botblox/RouterCore-Nano-DaughterBoard-Designs/RouterCoreNanoBaseRevA/BOM-BB-RNB-A-1.xlsx

No | Ref | Value | Description | Manufacturer | Manufacturer Part Number | LCSC | Footprint | Quantity | Supplier 1 | Cost @10pcs | Cost @1000pcs
1 | C1, C5, C6, C13, C14, C18, | 0.1uF | CAP CER 0.1UF 50V X7R 0402 | Murata Electronics | GCM155R71H104KE02D | C85858 | Kpk:C_0402_Small | 6 | LCSC | 0.0085 | 0.0067
2 | C2, C3, C8, C9, C10, C11, C16, C17, | 47uF | CAP CER 47UF 10V X5R 0805 | TDK | C2012X5R1A476MTJ00E | C76636 | Capacitor_SMD:C_0805_2012Metric | 8 | LCSC | 0.1986 | 0.122
3 | C4, C7, C12, C15, | 1uF | CAP CER 1UF 10V X6S 0402 | Murata Electronics | GRM155C81A105KA12D | C162161 | Kpk:C_0402_Small | 4 | LCSC | 0.0285 | 0.0204
4 | C19, C20, C21, | 22uF | CAP CER 22UF 10V X7R 0805 | Murata Electronics | GRM21BZ71A226ME15L | C907991 | Capacitor_SMD:C_0805_2012Metric | 3 | LCSC | 0.2551 | 0.1752
5 | C22, C23, | 2.2u | CAP CER 2.2UF 100V X7R 1206 | Samsung Electro-Mechanics | CL31B225KCHSNNE | C170101 | Kpk:C_1206_Small | 2 | LCSC | 0.1339 | 0.0826
6 | C24, | 0.1uF/100V | CAP CER 0.1UF 100V X7R 0603 | YAGEO | CC0603KRX7R0BB104 | C113803 | Kpk:C_0603_Small | 1 | LCSC | 0.0116 | 0.0088
7 | D1, | Zener12V | DIODE ZENER 12V 300MW SOD323 | ON Semiconductor | MM3Z12VT1G | C236177 | Diode_SMD:D_SOD-323 | 1 | LCSC | 0.0474 | 0.0337
8 | D2, | SMAJ54CA | TVS DIODE 54V 87.1V DO214AC | Littelfuse | SMAJ54CA | C2649855 | Diode_SMD:D_SMA | 1 | LCSC | 0.1152 | 0.1104
9 | D3, D4, D5, | GREEN | LED GREEN CLEAR CHIP SMD | Everlight Elec | 16-213SYGC/S530-E3/TR8 | C264408 | LED_SMD:LED_0402_1005Metric | 3 | LCSC | 0.0211 | 0.0135
10 | H1, H2, H3, H4, | SMTWE2050MTJ | ROUND STANDOFF M2X0.4 STEEL 5MM | Sinhoo | SMTWE2050MTJ | C2928183 | Kpk:MountingHole_M2_9774050243R_SMTWE2050MTJ | 4 | LCSC | 0.1076 | 0.1017
11 | J1, | LSHM-150-02.5-L-DV-A-N-K-TR | CONN SELF-MATE 100POS SMD GOLD | Samtec Inc. | LSHM-150-02.5-L-DV-A-N-K-TR | C2940507 | Connector_Samtec:Samtec_LSHM-150-xx.x-x-DV-N_2x50_P0.50mm_Vertical | 1 | Digikey | 6.371 | 4.64002
12 | J2, J3, J4, J5, J6, J7, J8, J9, J10, J11, J12, | 2147210080 | ZERO-HACHI 8P 0.8 HDR SR RA ETP | Molex | 2147210080 | C5492017 | Kpk:Molex_Zero-Hachi_214721-00XX_1x08_P0.8mm_Horizontal | 11 | Digikey | 1.311 | 0.94681
13 | J13, J14, | SFP+ | CONN SFP+ RCPT 20POS SLD R/A SMD | Molex | 744410001 | C277615 | Kpk:Connector_SFP | 2 | LCSC | 0.6597 | 0.43
14 | L1, L2, L3, L4, | 3.3uH | FIXED IND 3.3UH 1.8A 135MOHM SMD | Murata Electronics | DFE252012F-3R3M=P2 | C2041573 | Inductor_SMD:L_1008_2520Metric | 4 | LCSC | 0.197 | 0.1445
15 | L5, | 2.2uH | FIXED IND 2.2UH 7A 29 MOHM SMD | Shenzhen Sunlord Electronics Co., Ltd. | MWSA0503S-2R2MT | C408408 | Inductor_SMD:L_Sunlord_MWSA0503S | 1 | LCSC | 0.1542 | 0.1012
16 | N1, | SFP+_CAGE | CONN SFP+ CAGE 1X2 PRESS-FIT R/A | CND-tek | SFP 20072631 1X2Y+ | C42931391 | Kpk:AMPHENOL_U77A261M2071 | 1 | LCSC | 1.2274 | 0.8531
17 | Q1, | FDMC86139P | MOSFET P-CH 100V 4.4A/15A 8MLP | onsemi | FDMC86139P | C463243 | Kpk:VSON-8_3.3x3.3mm_P0.65mm_FDMC86139P | 1 | LCSC | 0.9686 | 0.6162
18 | R1, | DNP | DNP |  | DNP |  | Resistor_SMD:R_0603_1608Metric | 1
19 | R2, | 56K | RES SMD 56K OHM 1% 1/16W 0402 | YAGEO | RC0402FR-0756KL | C114756 | Resistor_SMD:R_0402_1005Metric | 1 | LCSC | 0.0026 | 0.002
20 | R3, R4, R10, R15, R24, | DNP | DNP |  | DNP |  | Resistor_SMD:R_0402_1005Metric | 5
21 | R5, R17, R27, | 1K | RES SMD 1K OHM 1% 1/16W 0402 | YAGEO | RC0402FR-071KL | C106235 | Resistor_SMD:R_0402_1005Metric | 3 | LCSC | 0.0038 | 0.0029
22 | R6, R7, R8, R9, R11, R12, R16, R18, R19, R20, R21, R22, R25, | 4.99K | RES 4.99K OHM 1% 1/16W 0402 | YAGEO | RC0402FR-074K99L | C137965 | Resistor_SMD:R_0402_1005Metric | 13 | LCSC | 0.0017 | 0.0014
23 | R13, R14, R23, | 100R | RES 100 OHM 1% 1/16W 0402 | YAGEO | RC0402FR-07100RL | C106232 | Resistor_SMD:R_0402_1005Metric | 3 | LCSC | 0.0022 | 0.0018
24 | R26, R29, | 10K | RES SMD 10K OHM 1% 1/16W 0402 | YAGEO | RC0402FR-0710KL | C60490 | Resistor_SMD:R_0402_1005Metric | 2 | LCSC | 0.0023 | 0.0019
25 | R28, | 31.6K | RES 31.6K OHM 1% 1/16W 0402 | YAGEO | RC0402FR-0731K6L | C276265 | Resistor_SMD:R_0402_1005Metric | 1 | LCSC | 0.0012 | 0.001
26 | TP1, TP2, TP3, TP4, TP5, TP6, TP7, TP8, | TP | TestPoint |  | DNP |  | TestPoint:TestPoint_Pad_D1.0mm | 8
27 | U1, | TCA9543APWR | IC BUS SWITCH 2 X 1:2 14-TSSOP | Texas Instruments | TCA9543APWR | C2653307 | Package_SO:TSSOP-14_4.4x5mm_P0.65mm | 1 | LCSC | 0.7306 | 0.5254
28 | U2, | LMR51635YDDCR | SIMPLE SWITCHER SYNCHRONOUS BUCK | Texas Instruments | LMR51635YDDCR | C45262770 | Package_TO_SOT_SMD:SOT-23-6 | 1 | LCSC | 1.5997 | 1.1365
 |  |  |  |  |  |  |  |  |  | 31.0832 | 22.15323
