botblox/RouterCore-Nano-DaughterBoard-Designs/RouterCoreBaseRevA Manufacture Data/BB-RPB-A-1 Manufacture Data/BOM-BB-RPB-A-1.xlsx

No | Ref | Value | Description | Manufacturer | Manufacturer Part Number | LCSC | Footprint | Quantity | Supplier 1 | Cost @10pcs | Cost @1000pcs
1 | C1, C2, C7, C8, C10, C11, C16, C17, C18, C19, C24, C25, | 47uF | CAP CER 47UF 10V X5R 0805 | TDK | C2012X5R1A476MTJ00E | C76636 | Capacitor_SMD:C_0805_2012Metric | 12 | LCSC | 0.1599 | 0.0817
2 | C3, C6, C12, C15, C20, C23, | 1uF | CAP CER 1UF 10V X6S 0402 | Murata Electronics | GRM155C81A105KA12D | C162161 | Kpk:C_0402_Small | 6 | LCSC | 0.0122 | 0.0098
3 | C4, C5, C9, C13, C14, C21, C22, C26, | 0.1uF | CAP CER 0.1UF 50V X7R 0402 | Murata Electronics | GCM155R71H104KE02D | C85858 | Kpk:C_0402_Small | 8 | LCSC | 0.003 | 0.0023
4 | C27, C28, C32, | 22uF | CAP CER 22UF 10V X7R 0805 | Murata Electronics | GRM21BZ71A226ME15L | C907991 | Capacitor_SMD:C_0805_2012Metric | 3 | LCSC | 0.121 | 0.0787
5 | C29, C30, | 2.2u | CAP CER 2.2UF 100V X7R 1206 | Samsung Electro-Mechanics | CL31B225KCHSNNE | C170101 | Kpk:C_1206_Small | 2 | LCSC | 0.0758 | 0.0507
6 | C31, | 0.1uF/100V | CAP CER 0.1UF 100V X7R 0603 | YAGEO | CC0603KRX7R0BB104 | C113803 | Kpk:C_0603_Small | 1 | LCSC | 0.0041 | 0.0031
7 | D1, | 12V | DIODE ZENER 12V 300MW SOD323 | ON Semiconductor | MM3Z12VT1G | C236177 | Diode_SMD:D_SOD-323 | 1 | LCSC | 0.0508 | 0.0354
8 | D2, | SMAJ54CA | TVS DIODE 54V 87.1V DO214AC | Littelfuse | SMAJ54CA | C2649855 | Diode_SMD:D_SMA | 1 | LCSC | 0.1721 | 0.1052
9 | D3, D4, D5, D6, | GREEN | LED GREEN CLEAR CHIP SMD | Everlight Elec | 16-213SYGC/S530-E3/TR8 | C264408 | LED_SMD:LED_0402_1005Metric | 4 | LCSC | 0.0224 | 0.0143
10 | H1, H2, H3, H4, | MountingHole | MountingHole |  | DNP |  | MountingHole:MountingHole_2.7mm_M2.5 | 4
11 | H5, H6, H7, H8, | MountingHole | MountingHole |  | DNP |  | Kpk:MountingHole_2.3mm_M2 | 4
12 | J1, | SEAF-20-05.0-L-10-2-A-K-TR | CONN HD ARRAY RCPT 200P SMD GOLD | SAMTEC | SEAF-20-05.0-L-10-2-A-K-TR | C6216347 | Kpk:SAMTEC_SEAF-20-05.0-L-10-2-A-K-TR | 1 | Digi-Key | 16.856 | 10.1
13 | J2, | 2147210101 | ZERO-HACHI 10P 0.8 HDR SR RA ETP AU | Molex | 2147210101 | C19802771 | Kpk:Molex_Zero-Hachi_214721-00XX_1x10_P0.8mm_Horizontal | 1 | Digi-Key | 2.096 | 1.55214
14 | J4, | 2147210121 | ZERO-HACHI 12P 0.8 HDR SR RA ETP AU | Molex | 2147210121 |  | Kpk:Molex_Zero-Hachi_214721-00XX_1x12_P0.8mm_Horizontal | 1 | Digi-Key | 2.082 | 1.54114
15 | J5, J6, J7, J8, J9, J10, J11, J12, J13, J14, J15, J16, J17, J18, J19, J20, | 2147210081 | ZERO-HACHI 8P 0.8 HDR SR RA ETP AU | Molex | 2147210081 |  | Kpk:Molex_Zero-Hachi_214721-00XX_1x08_P0.8mm_Horizontal | 16 | Digi-Key | 1.425 | 1.0296
16 | J21, J22, J23, | SFP+ | CONN SFP+ RCPT 20POS SLD R/A SMD | Molex | 744410001 | C277615 | Kpk:Connector_SFP | 3 | LCSC | 0.6954 | 0.4771
17 | L1, L2, L3, L4, L5, L6, | 3.3uH | FIXED IND 3.3UH 1.8A 135MOHM SMD | Murata Electronics | DFE252012F-3R3M=P2 | C2041573 | Inductor_SMD:L_1008_2520Metric | 6 | LCSC | 0.1702 | 0.107
18 | L7, | 2.2uH | FIXED IND 2.2UH 7A 29 MOHM SMD | Shenzhen Sunlord Electronics Co., Ltd. | MWSA0503S-2R2MT | C408408 | Inductor_SMD:L_Sunlord_MWSA0503S | 1 | LCSC | 0.2667 | 0.1561
19 | N1, | DNP | DNP |  | DNP |  | Kpk:Connector_SFP_and_Cage_10731013W008_CZT_SmallCageHole_Custom | 1
20 | Q1, | FDMC86139P | MOSFET P-CH 100V 4.4A/15A 8MLP | onsemi | FDMC86139P | C463243 | Kpk:VSON-8_3.3x3.3mm_P0.65mm_FDMC86139P | 1 | LCSC | 0.7194 | 0.4607
21 | R1, | DNI | DNP |  | DNP |  | Resistor_SMD:R_0603_1608Metric | 1
22 | R2, | 56K | RES SMD 56K OHM 1% 1/16W 0402 | Yageo | RC0402FR-0756KL | C114756 | Resistor_SMD:R_0402_1005Metric | 1 | LCSC | 0.0007 | 0.0005
23 | R3, R16, R25, R35, | 1K | RES SMD 1K OHM 1% 1/16W 0402 | Yageo | RC0402FR-071KL | C106235 | Resistor_SMD:R_0402_1005Metric | 4 | LCSC | 0.0006 | 0.0005
24 | R4, R5, R6, R7, R8, R13, R17, R18, R19, R20, R21, R24, R26, R27, R28, R29, R30, R33, | 4.99K | RES 4.99K OHM 1% 1/16W 0402 | Yageo | RC0402FR-074K99L | C137965 | Resistor_SMD:R_0402_1005Metric | 18 | LCSC | 0.0007 | 0.0005
25 | R9, R15, R22, R31, | 100R | RES 100 OHM 1% 1/16W 0402 | Yageo | RC0402FR-07100RL | C106232 | Resistor_SMD:R_0402_1005Metric | 4 | LCSC | 0.0007 | 0.0006
26 | R10, R11, R12, R14, R23, R32, | DNP | DNP |  | DNP |  | Resistor_SMD:R_0402_1005Metric | 6
27 | R34, R37, | 10K | RES SMD 10K OHM 1% 1/16W 0402 | Yageo | RC0402FR-0710KL | C60490 | Resistor_SMD:R_0402_1005Metric | 2 | LCSC | 0.0006 | 0.0004
28 | R36, | 31.6K | RES 31.6K OHM 1% 1/16W 0402 | Yageo | RC0402FR-0731K6L | C276265 | Resistor_SMD:R_0402_1005Metric | 1 | LCSC | 0.0007 | 0.0005
29 | TP1, TP2, TP3, TP4, TP5, TP6, TP7, TP8, TP9, TP10, | TP | TestPoint |  | DNP |  | TestPoint:TestPoint_Pad_D1.0mm | 10
30 | U1, | TCA9544A | IC MULTIPLEXER 1 X 1:4 20TSSOP | Texas Instruments | TCA9544APWR | C2674619 | Package_SO:TSSOP-20_4.4x6.5mm_P0.65mm | 1 | Texas Instruments | 0.6667 | 0.4226
31 | U2, | LMR51635YDDCR | SIMPLE SWITCHER SYNCHRONOUS BUCK | Texas Instruments | LMR51635YDDCR | C45262770 | Package_TO_SOT_SMD:SOT-23-6 | 1 | Digi-Key | 1.605 | 0.7
 |  |  |  |  |  |  |  |  |  | 53.0668 | 35.09078
