botblox/RouterCore-Nano-DaughterBoard-Designs/RouterCoreNanoBaseRevA/3D-BB-RNB-A-1.step

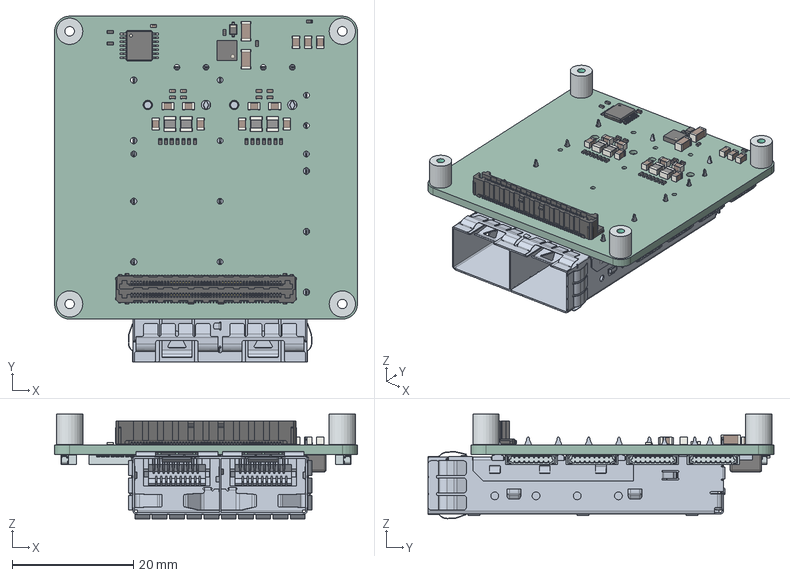
[picture p1: CAD file, 2026-10-26]
RouterCoreNanoBaseRevA/3D-BB-RNB-A-1.step
50.0 x 57.1 x 17.2 mm
C_0805_2012Metric x 11
R_0402_1005Metric x 23
VSON_8_33x33mm_Pitch065mm_NexFET
L_1008_2520Metric x 4
C_0402_1005Metric x 10
C_1206_3216Metric x 2
LSHM-150-02.5-L-DV-A-N-TR
TSSOP_14_44x5mm_P065mm
D_SOD_323
D_SMA
2147210081wbm000_01 x 11
SOT_23_6
CQ assembly
LED_0402_1005Metric x 3
M-U77-A261M-X071-REVT1
C_0603_1608Metric
RouterCoreNanoBaseRevA_PCB
