botblox/RouterCore-Nano-DaughterBoard-Designs/RouterCoreBaseRevA Manufacture Data/BB-RPB-A-1 Manufacture Data/PCB FABRICATION NOTES - BB-RPB-A-1.docx

PCB FABRICATION NOTES

BOARD NAME:

KAPEK BB-RPB-A-1

1) PCB TO BE MANUFACTURED IN ACCORDANCE WITH IPC6012, CURRENT REVISION, PERFORMANCE CLASS 2.

2) 8-LAYER RIGID PCB. MATERIAL FR4 1.6mm THICK.

3) PROCESS: APPLY GREEN SOLDERMASK OVER BARE COPPER ON L1 (TOP) AND L8 (BOTTOM).

4) APPLY ENIG TO EXPOSED PADS ON, L1 AND L8, AFTER SOLDERMASK. MINIMUM THICKNESS PER IPC6012 CLASS 2.

5) SILKSCREEN COMPONENT LOCATION MARKINGS, WHITE PERMANENT, NON-CONDUCTIVE INK, L1 AND L8, PER SUPPLIED GERBER FILE.

6) MINIMUM COPPER IN PLATED HOLES PER IPC6012, CURRENT REVISION, CLASS 2.

7) ALL TOLERANCES PER IPC6012 CLASS 2.

8) FABRICATE AND INSPECT TO IPC CLASS 2 STANDARDS. PCB IS FOR INDUSTRIAL USE. IN CASE OF CONFLICT, SUPERCEDE IPC SPECIFICATION.

9) LAYER 1 IS TOP COPPER. LAYER SEQUENCE IS TOP / IN1 / IN2 / IN3 / IN4 / IN5/ IN6 /BOT (L1 / L2 / L3 / L4 / L5 / L6 / L7 / L8).

10) 100% ELECTRICAL TEST REQUIRED FOR SHORTS AND OPENS.

11) SUPPLY AS INDIVIDUAL PCBS.

12) IF PAD IS LARGER THAN NON-PLATED HOLE, DO NOT REMOVE PAD, AND DO NOT REMOVE ANY COPPER FROM PAD.

13) USE 1-OZ ON EXTERNAL LAYERS.

14) USE 1-OZ ON INTERNAL LAYERS.

15) IMPEDANCE REQUIREMENT: 100 OHM DIFFERENTIAL PAIR AS IN ATTACHED FILES
