botblox/RouterCore-Nano-DaughterBoard-Designs/RouterCoreBaseRevA Manufacture Data/BB-RPB-A-1 Manufacture Data/3D Images/BB-RPB-A-1 BOT.png

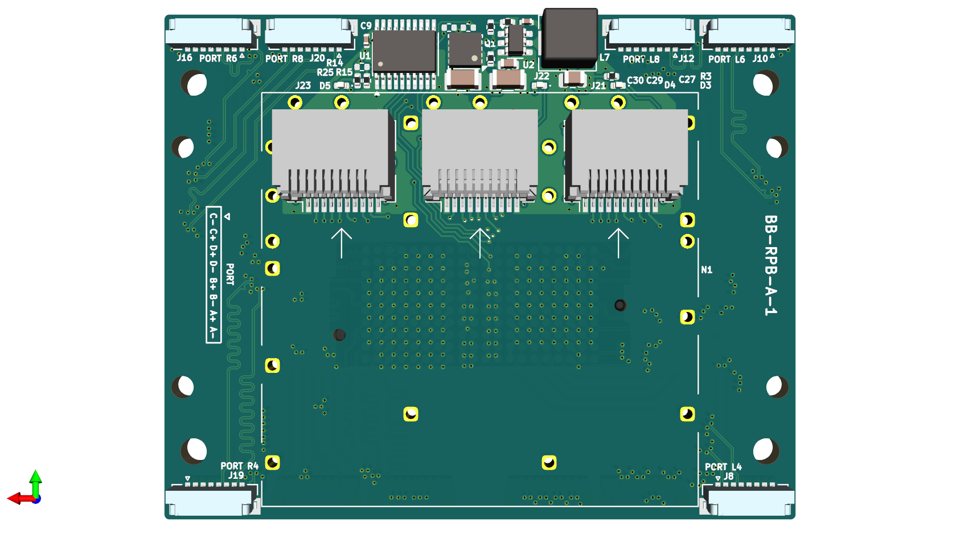
RouterCoreBaseRevA Manufacture Data/BB-RPB-A-1 Manufacture Data/3D Images/BB-RPB-A-1 BOT.png
