botblox/RouterCore-Nano-DaughterBoard-Designs/RouterCoreNanoBaseRevA/SCH-BB-RNB-A-1.pdf

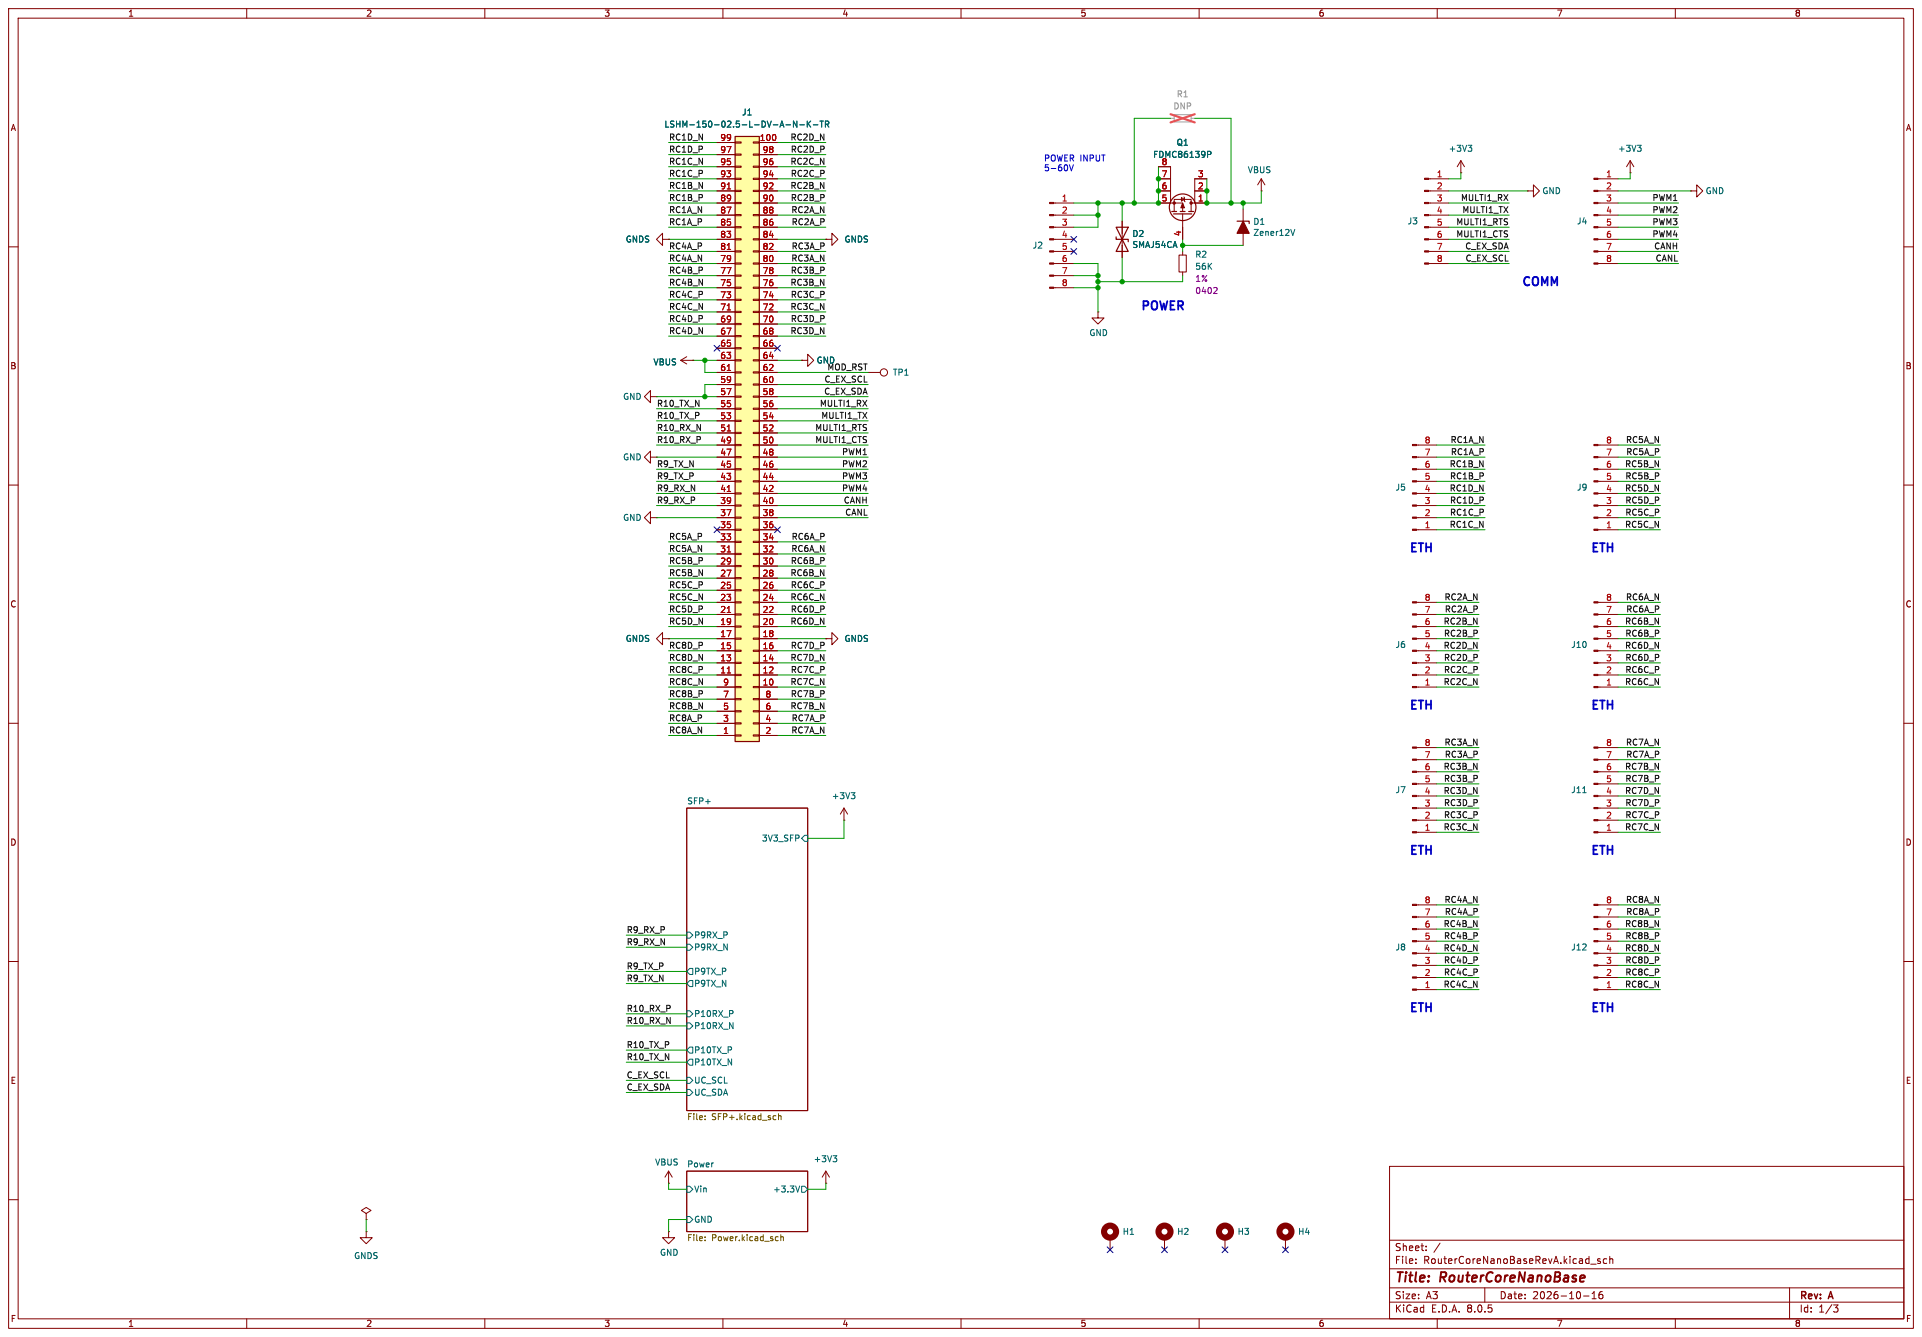
[picture p8: page 1]

Vin Power File: Power.kicad_sch

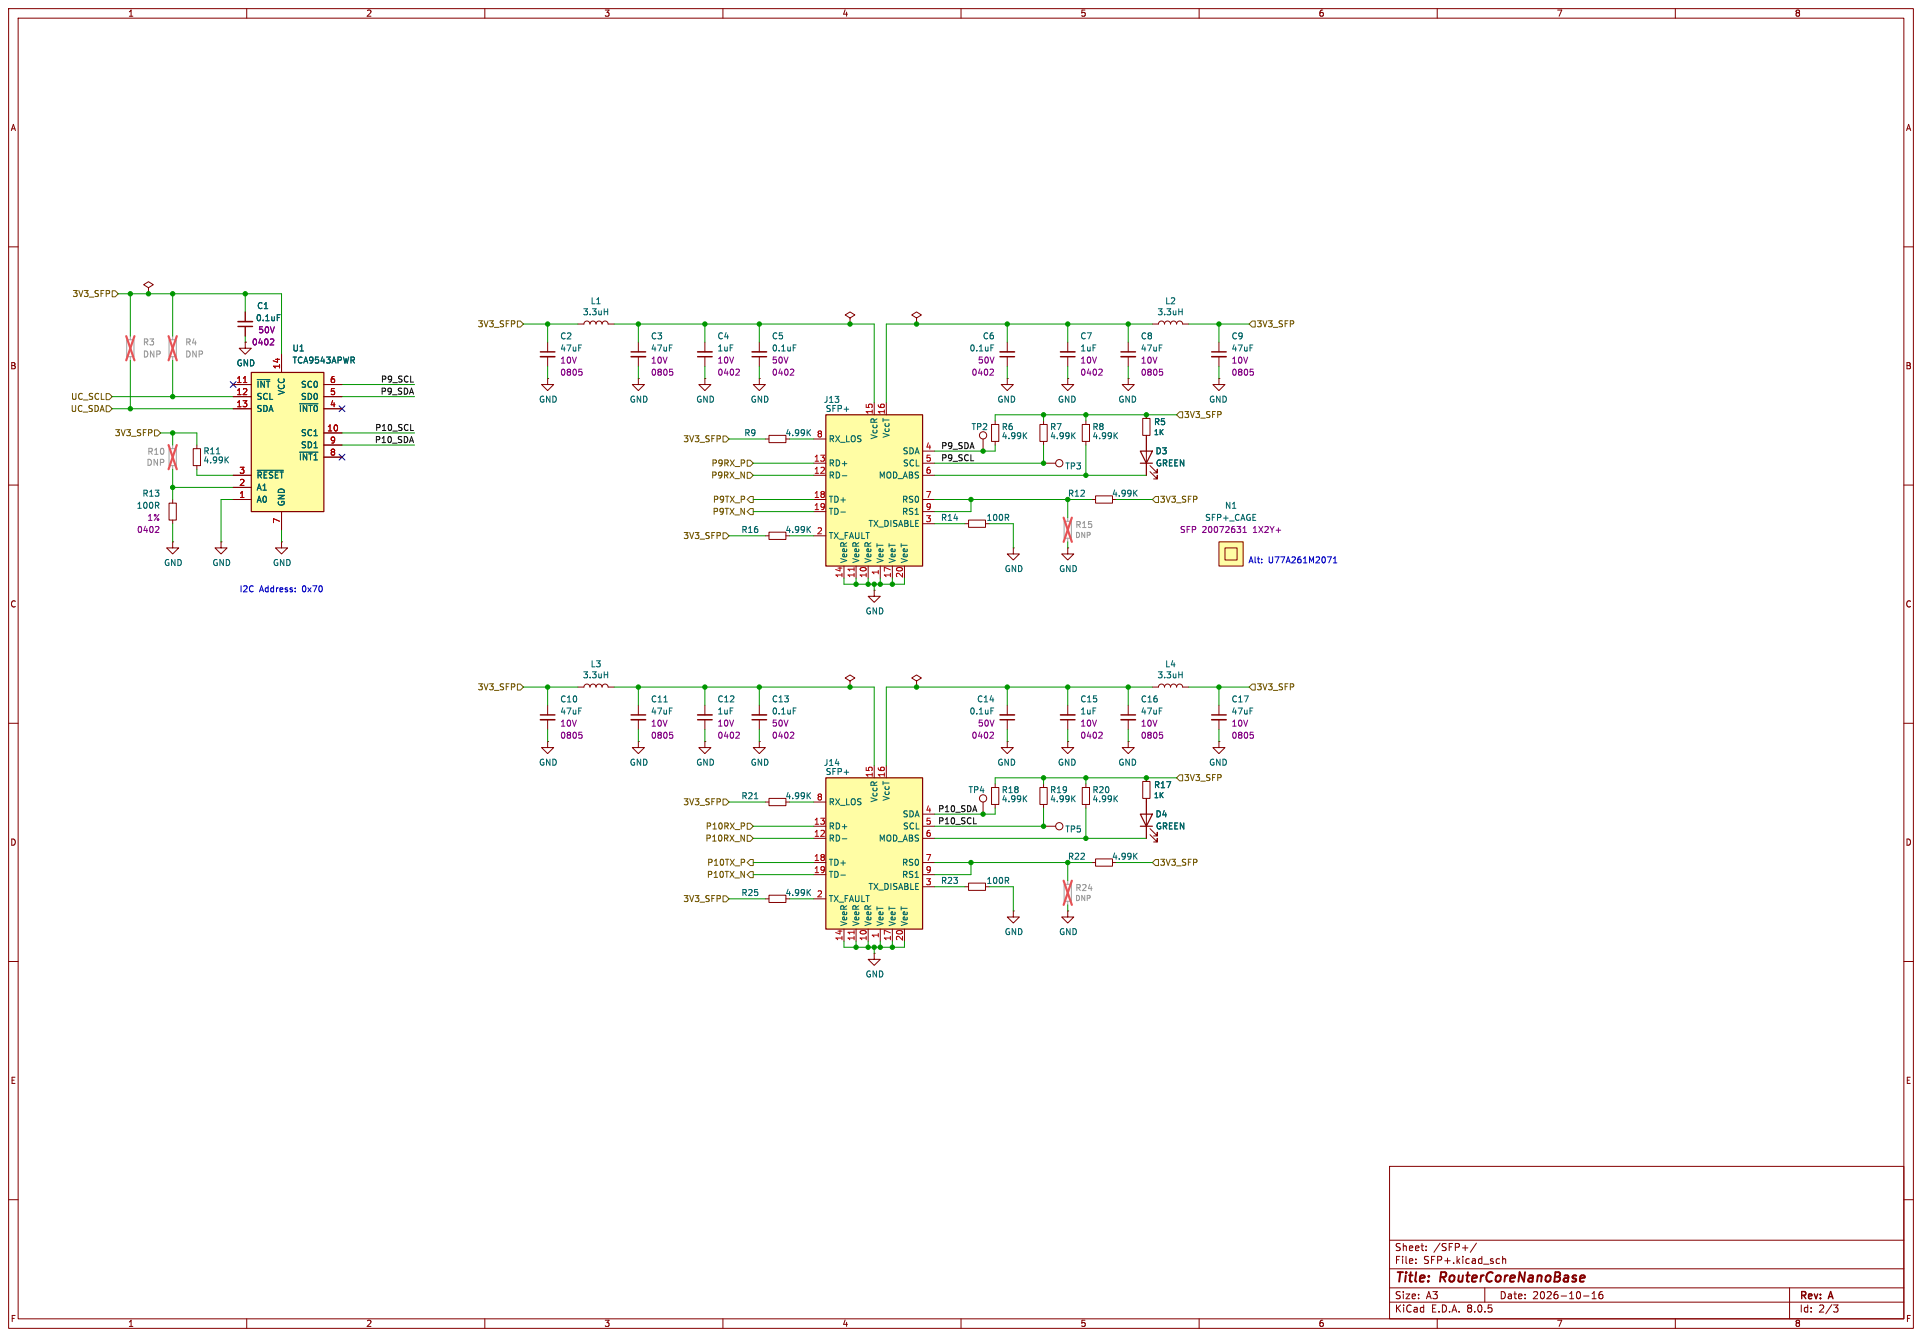
[picture p9: page 2]

1 VeeR 10 VeeR 11 RD- 12 RD+ 13 VeeR 14 VccR 15 VccT 16 VeeT 17 TD+ 18 TD- 19 TX_FAULT 2 VeeT 20 TX_DISABLE 3 SDA 4 SCL 5 MOD_ABS 6 RS0 7 RX_LOS 8 RS1 9

File: SFP+.kicad_sch Sheet: /SFP+/ VeeT

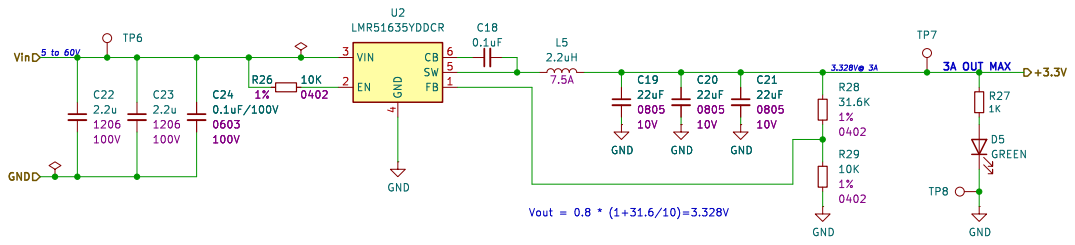
[picture p10: page 3]

File: Power.kicad_sch Sheet: /Power/
Id: 3/3 Title: RouterCoreNanoBase
