botblox/RouterCore-Nano-DaughterBoard-Designs/RouterCoreBaseRevA Manufacture Data/BB-RPB-A-1 Manufacture Data/Impedance requirement/BOT-DiffPair100Ohm_YellowHighlighted.pdf

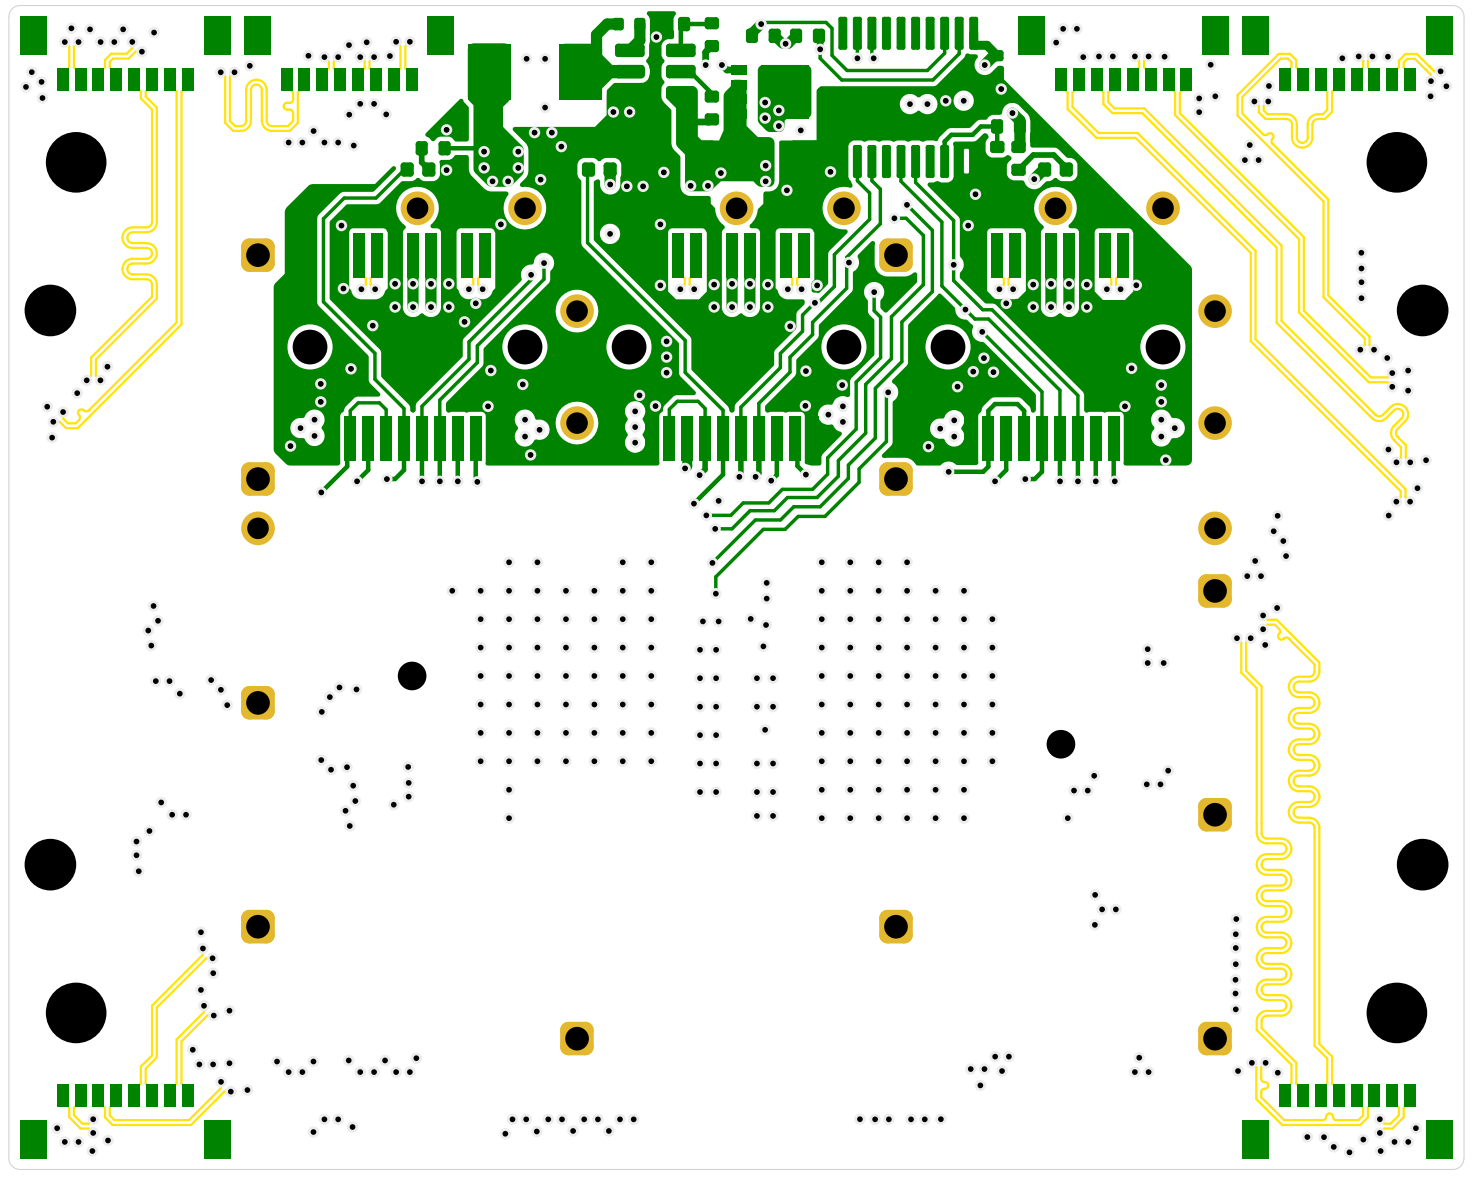
[picture p11: page 1]
