botblox/RouterCore-Nano-DaughterBoard-Designs/RouterCoreBaseRevA Manufacture Data/BB-RPB-A-1 Manufacture Data/Impedance requirement/IN2-DiffPair100Ohm_YellowHighlighted.pdf

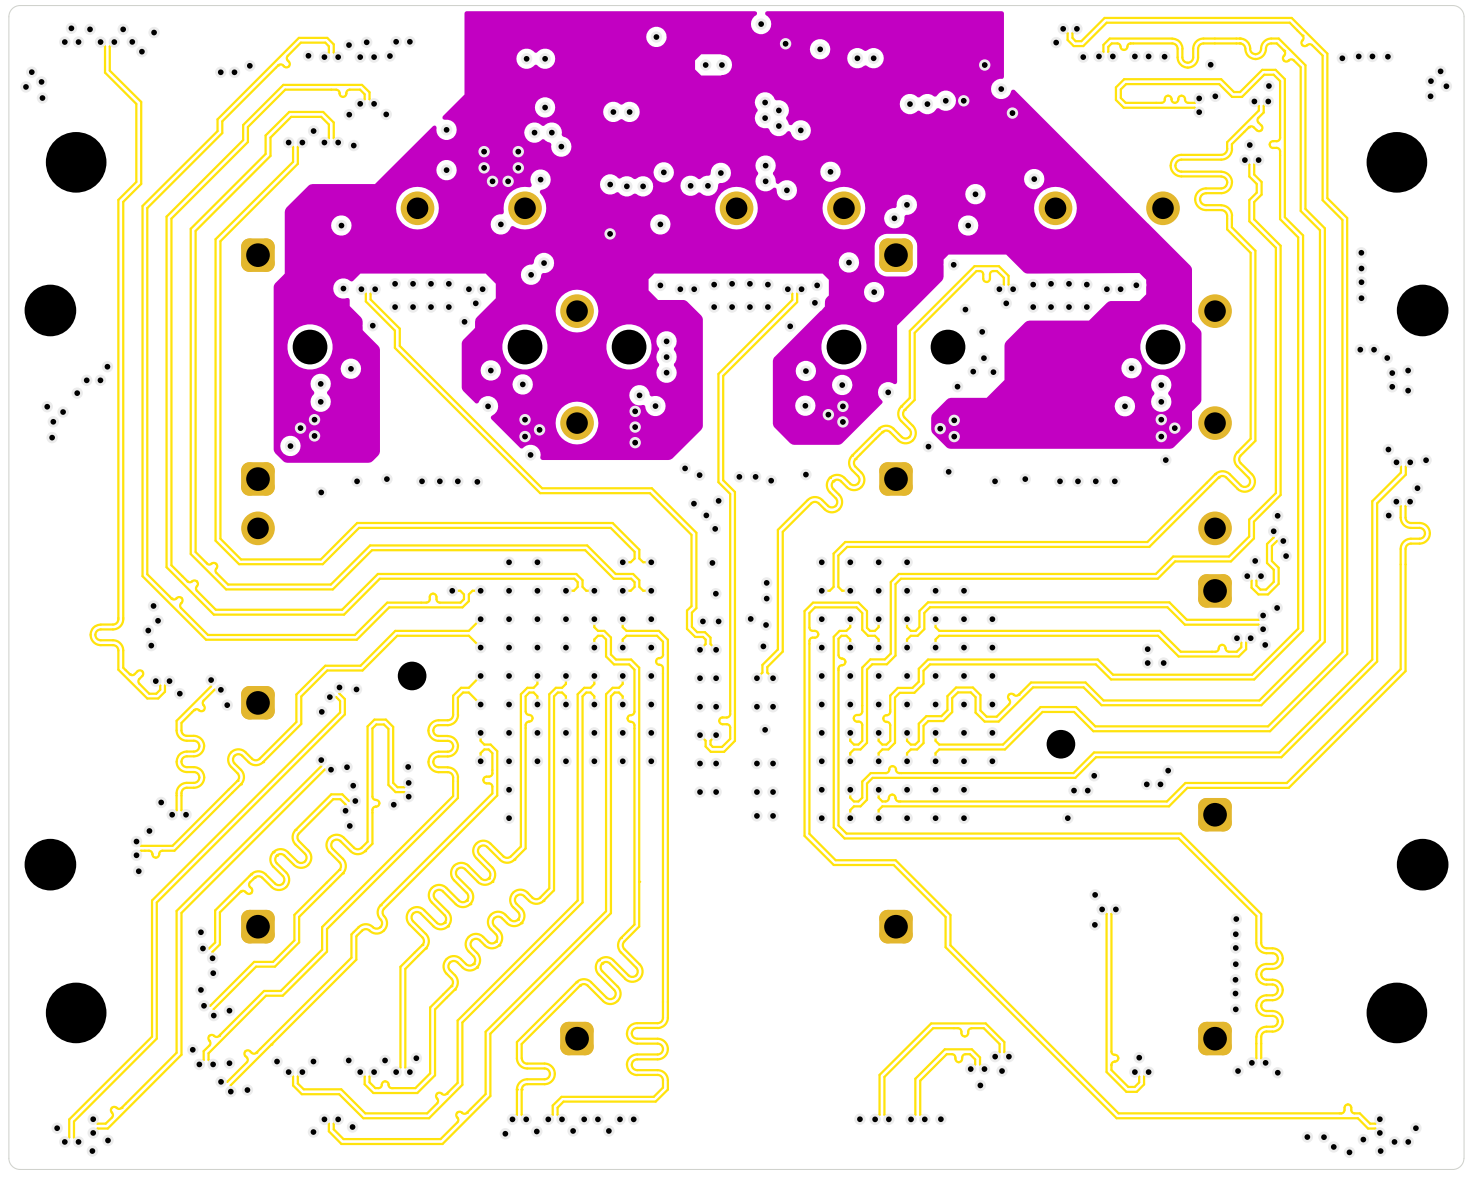
[picture p12: page 1]
