botblox/RouterCore-Nano-DaughterBoard-Designs/RouterCoreBaseRevA Manufacture Data/BB-RPB-A-1 Manufacture Data/Impedance requirement/IN4-DiffPair100Ohm_YellowHighlighted.pdf

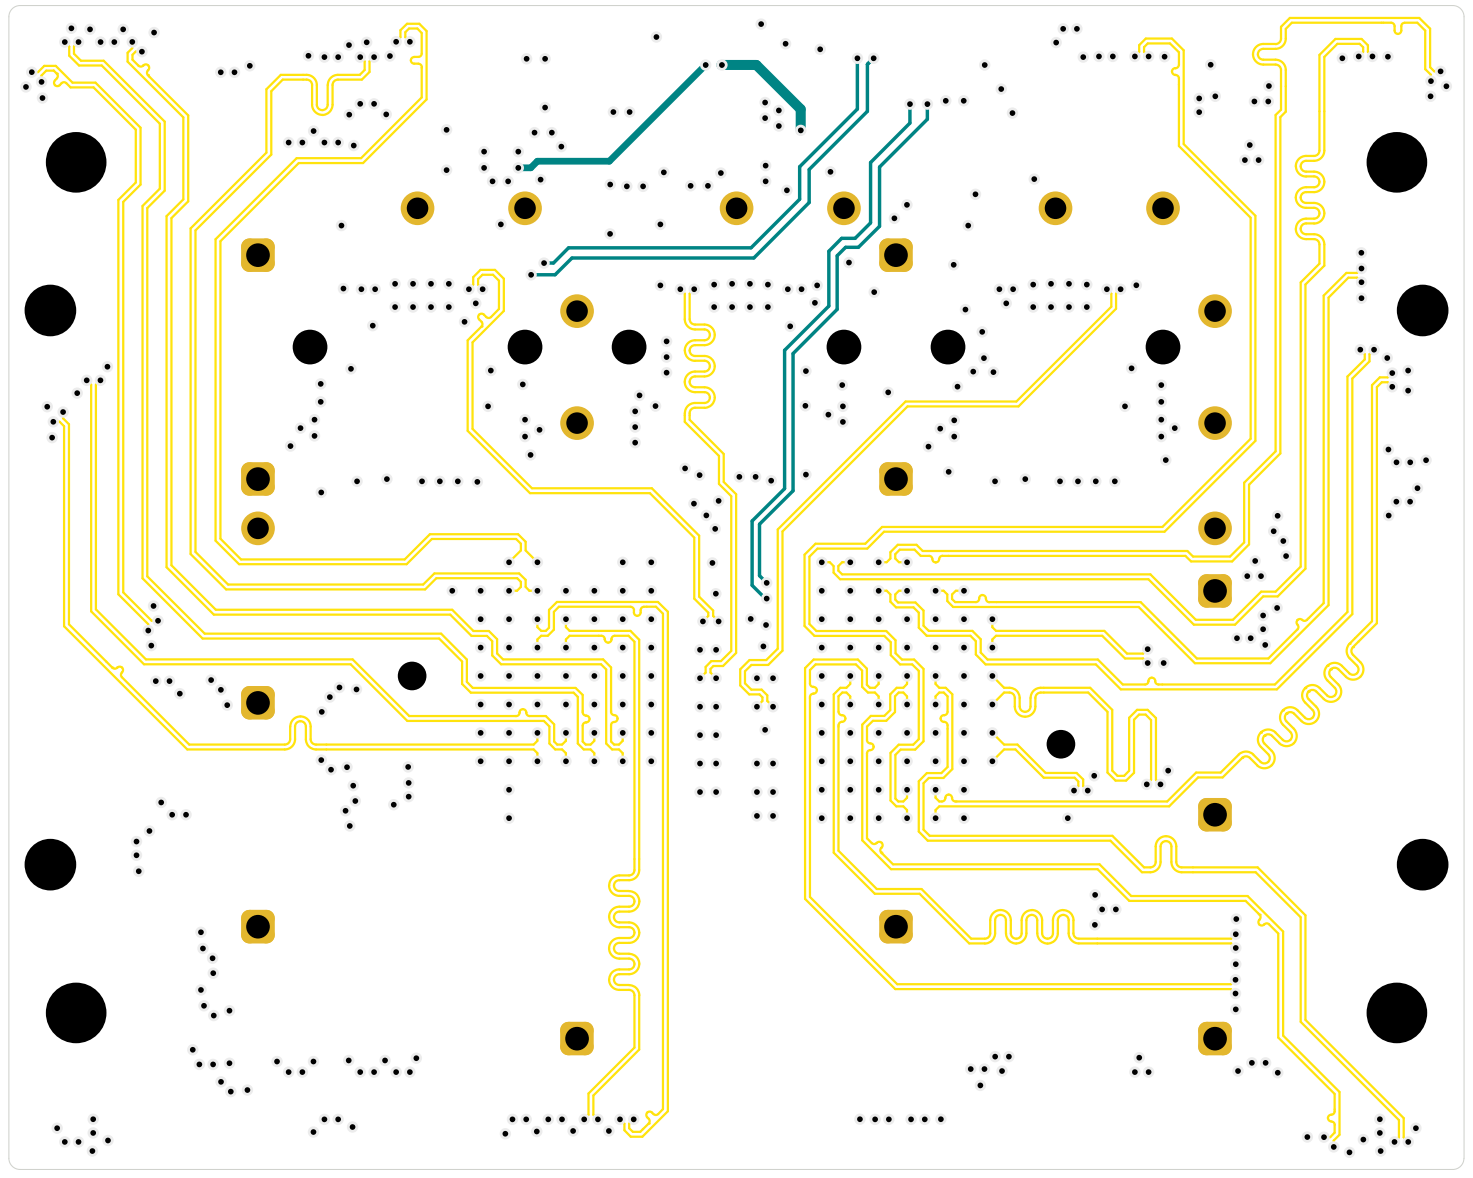
[picture p13: page 1]
