botblox/RouterCore-Nano-DaughterBoard-Designs/RouterCoreBaseRevA Manufacture Data/BB-RPB-A-1 Manufacture Data/Impedance requirement/TOP-DiffPair100Ohm_YellowHighlighted.pdf

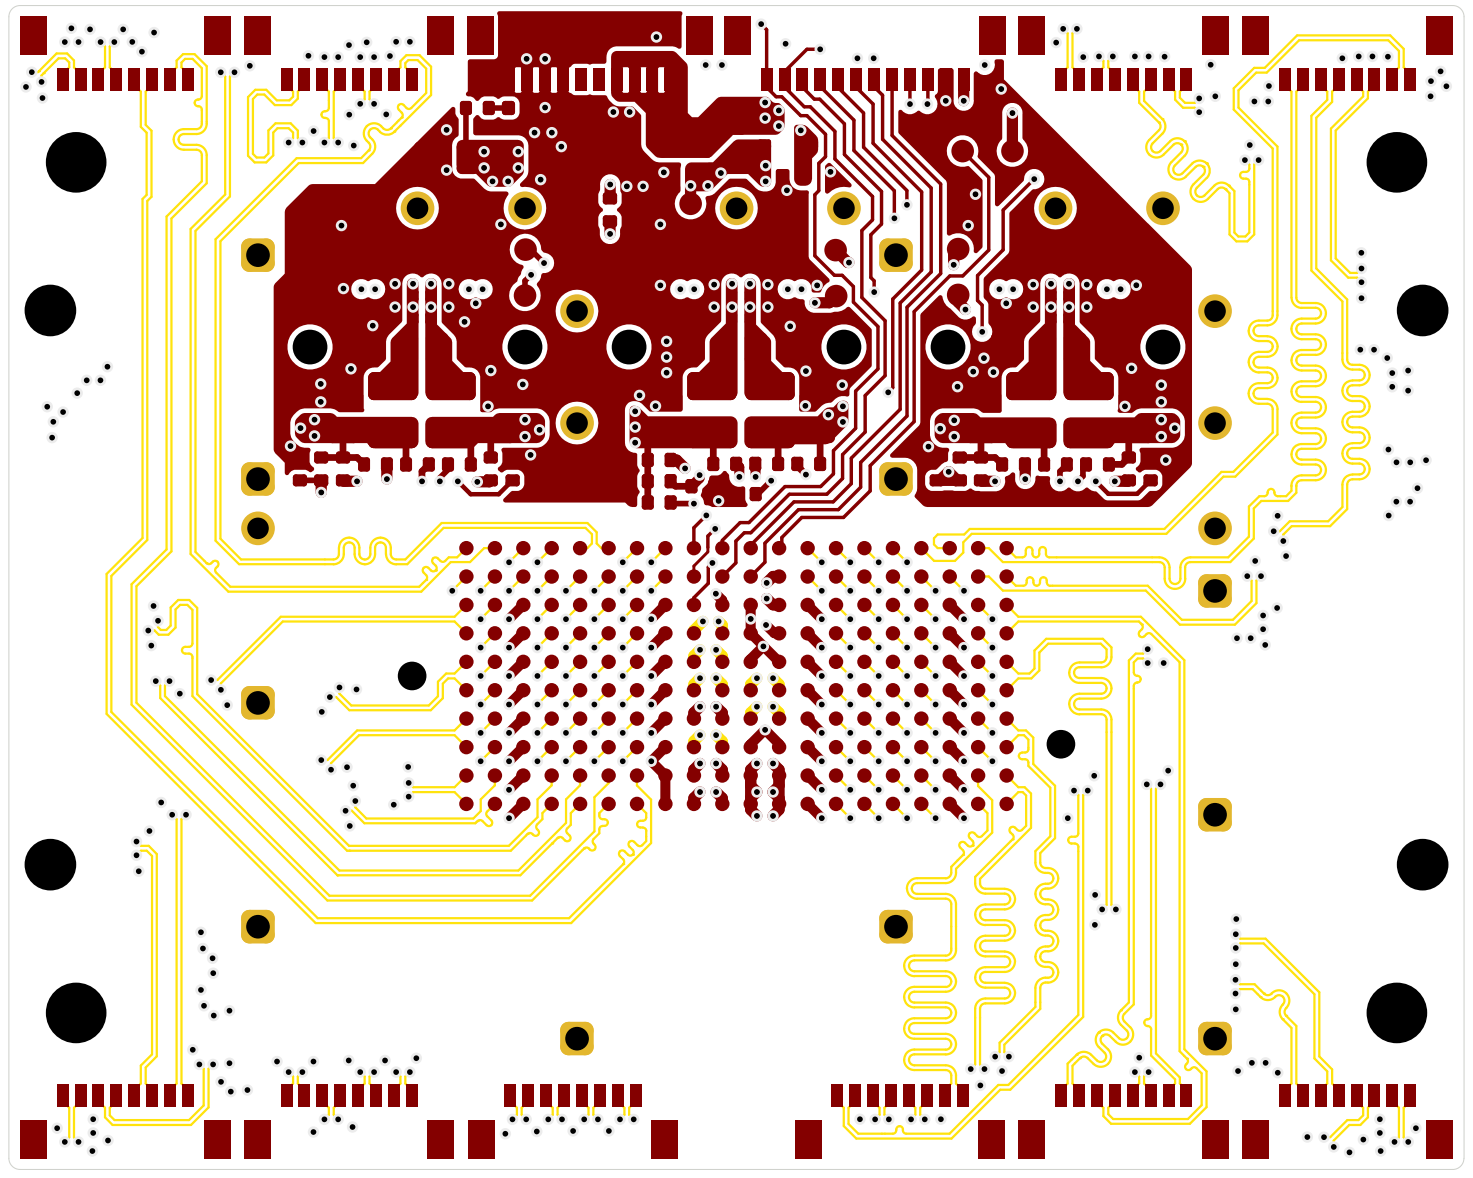
[picture p14: page 1]
