botblox/RouterCore-Nano-DaughterBoard-Designs/RouterCoreNanoBaseRevA/RouterCoreNanoBaseRevA.kicad_pcb

## KiCad design RouterCoreNanoBaseRevA/RouterCoreNanoBaseRevA.kicad_pcb (2026-10-26)

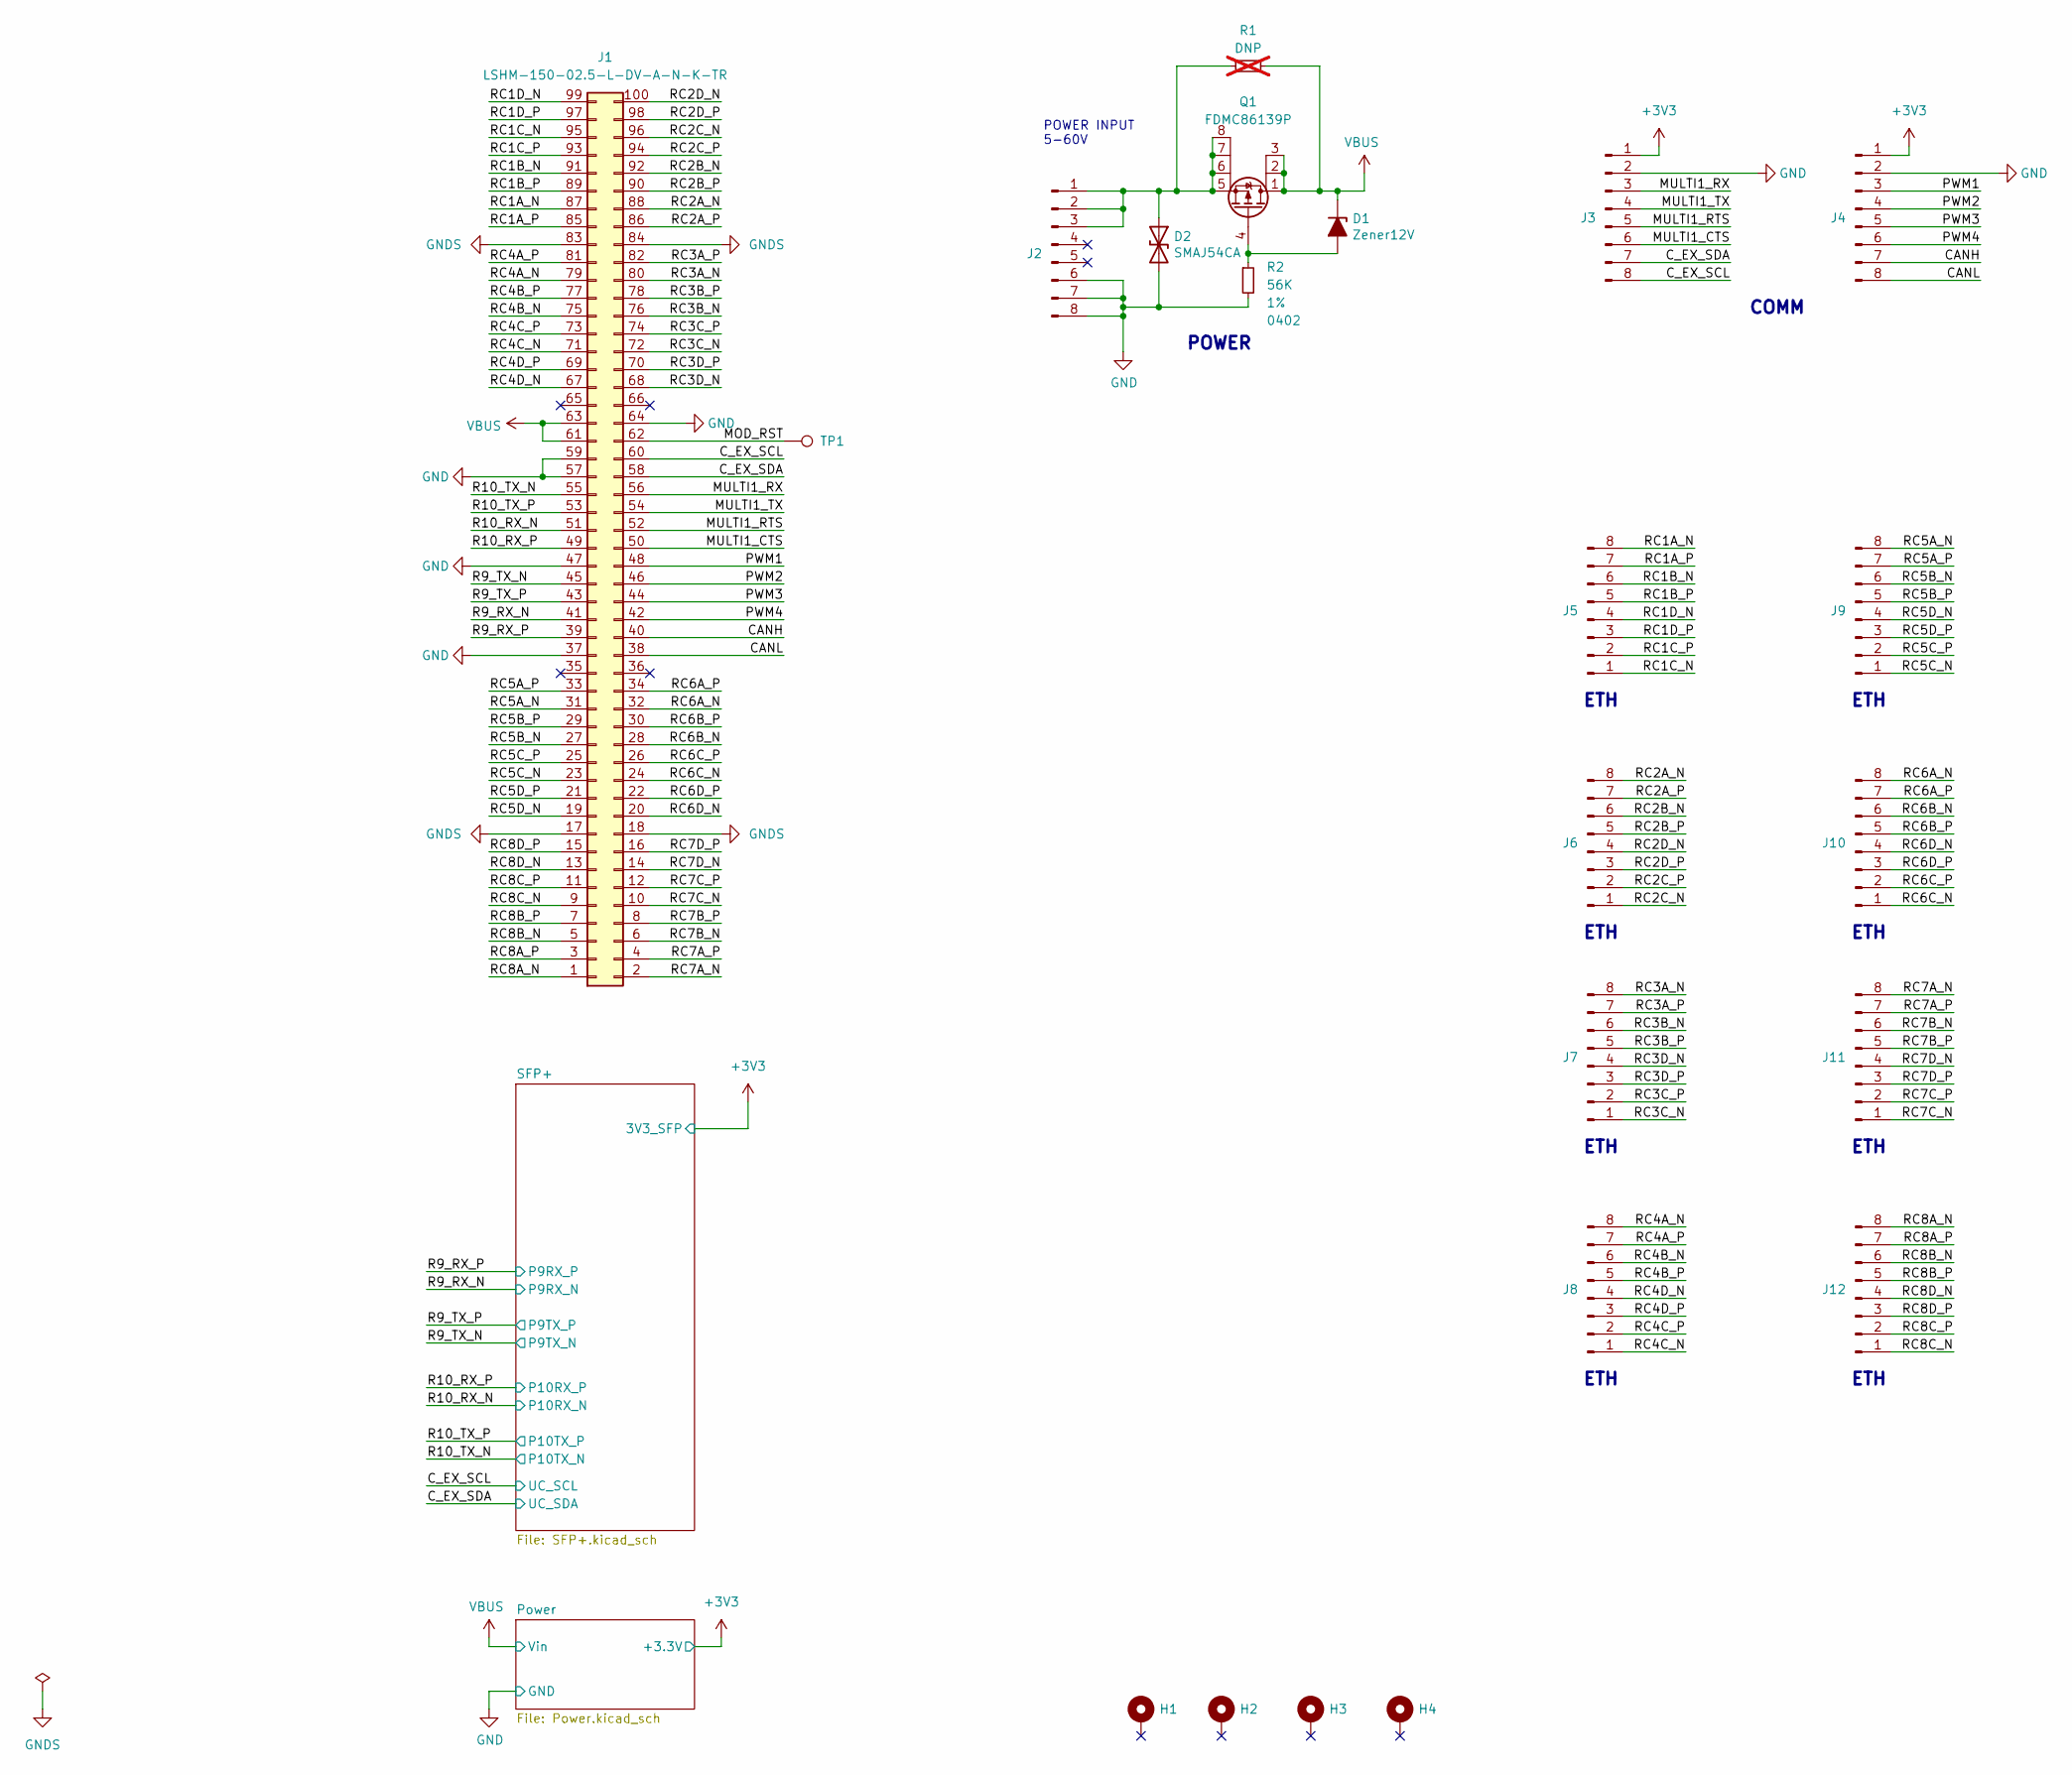
[picture p15: schematic RouterCoreNanoBaseRevA.kicad_sch, RouterCoreNanoBase]

Parts:
D1: Zener12V; D_SOD-323; VOLTAGE 12V; MFG1_PART# MM3Z12VT1G; JLC C236177
D2: SMAJ54CA; D_SMA; VOLTAGE 54V; MFG1_PART# SMAJ54CA; JLC C2649855
H1, H2, H3, H4: SMTWE2050MTJ; MountingHole_M2_9774050243R_SMTWE2050MTJ; MFG1_PART# SMTWE2050MTJ; JLC C2928183
J1: LSHM-150-02.5-L-DV-A-N-K-TR; Samtec_LSHM-150-xx.x-x-DV-N_2x50_P0.50mm_Vertical; MFG1_PART# LSHM-150-02.5-L-DV-A-N-K-TR; JLC C2940507
J2, J3, J4, J5, J6, J7, J8, J9, J10, J11, J12: 2147210080; Molex_Zero-Hachi_214721-00XX_1x08_P0.8mm_Horizontal; MFG1_PART# 2147210080; JLC C5492017
Q1: FDMC86139P; VSON-8_3.3x3.3mm_P0.65mm_FDMC86139P; VOLTAGE 100V; MFG1_PART# FDMC86139P; JLC C463243
R1: DNP; R_0603_1608Metric; MFG1_PART# DNP; not fitted
R2: 56K; R_0402_1005Metric; TOLERANCE 1%; MFG1_PART# RC0402FR-0756KL; JLC C114756
TP1: TP; TestPoint_Pad_D1.0mm; MFG1_PART# DNP

Connections:
+3V3: J3.1, J4.1; also elsewhere on the board
/CANH: J1.40, J4.7
/CANL: J1.38, J4.8
/C_EX_SCL: J1.60, J3.8; also elsewhere on the board
/C_EX_SDA: J1.58, J3.7; also elsewhere on the board
/MOD_RST: J1.62, TP1.1
/MULTI1_CTS: J1.50, J3.6
/MULTI1_RTS: J1.52, J3.5
/MULTI1_RX: J1.56, J3.3
/MULTI1_TX: J1.54, J3.4
/PWM1: J1.48, J4.3
/PWM2: J1.46, J4.4
/PWM3: J1.44, J4.5
/PWM4: J1.42, J4.6
/R9_RX_N: J1.41; also elsewhere on the board
/R9_RX_P: J1.39; also elsewhere on the board
/R9_TX_N: J1.45; also elsewhere on the board
/R9_TX_P: J1.43; also elsewhere on the board
/R10_RX_N: J1.51; also elsewhere on the board
/R10_RX_P: J1.49; also elsewhere on the board
/R10_TX_N: J1.55; also elsewhere on the board
/R10_TX_P: J1.53; also elsewhere on the board
/RC1A_N: J1.87, J5.8
/RC1A_P: J1.85, J5.7
/RC1B_N: J1.91, J5.6
/RC1B_P: J1.89, J5.5
/RC1C_N: J1.95, J5.1
/RC1C_P: J1.93, J5.2
/RC1D_N: J1.99, J5.4
/RC1D_P: J1.97, J5.3
/RC2A_N: J1.88, J6.8
/RC2A_P: J1.86, J6.7
/RC2B_N: J1.92, J6.6
/RC2B_P: J1.90, J6.5
/RC2C_N: J1.96, J6.1
/RC2C_P: J1.94, J6.2
/RC2D_N: J1.100, J6.4
/RC2D_P: J1.98, J6.3
/RC3A_N: J1.80, J7.8
/RC3A_P: J1.82, J7.7
/RC3B_N: J1.76, J7.6
/RC3B_P: J1.78, J7.5
/RC3C_N: J1.72, J7.1
/RC3C_P: J1.74, J7.2
/RC3D_N: J1.68, J7.4
/RC3D_P: J1.70, J7.3
/RC4A_N: J1.79, J8.8
/RC4A_P: J1.81, J8.7
/RC4B_N: J1.75, J8.6
/RC4B_P: J1.77, J8.5
/RC4C_N: J1.71, J8.1
/RC4C_P: J1.73, J8.2
/RC4D_N: J1.67, J8.4
/RC4D_P: J1.69, J8.3
/RC5A_N: J1.31, J9.8
/RC5A_P: J1.33, J9.7
/RC5B_N: J1.27, J9.6
/RC5B_P: J1.29, J9.5
/RC5C_N: J1.23, J9.1
/RC5C_P: J1.25, J9.2
/RC5D_N: J1.19, J9.4
/RC5D_P: J1.21, J9.3
/RC6A_N: J1.32, J10.8
/RC6A_P: J1.34, J10.7
/RC6B_N: J1.28, J10.6
/RC6B_P: J1.30, J10.5
/RC6C_N: J1.24, J10.1
/RC6C_P: J1.26, J10.2
/RC6D_N: J1.20, J10.4
/RC6D_P: J1.22, J10.3
/RC7A_N: J1.2, J11.8
/RC7A_P: J1.4, J11.7
/RC7B_N: J1.6, J11.6
/RC7B_P: J1.8, J11.5
/RC7C_N: J1.10, J11.1
/RC7C_P: J1.12, J11.2
/RC7D_N: J1.14, J11.4
/RC7D_P: J1.16, J11.3
/RC8A_N: J1.1, J12.8
/RC8A_P: J1.3, J12.7
/RC8B_N: J1.5, J12.6
/RC8B_P: J1.7, J12.5
/RC8C_N: J1.9, J12.1
/RC8C_P: J1.11, J12.2
/RC8D_N: J1.13, J12.4
/RC8D_P: J1.15, J12.3
GND: D2.2 (A2), J1.37, J1.47, J1.57, J1.59, J1.64, J2.6, J2.7, J2.8, J3.2, J4.2, R2.2; also elsewhere on the board
GNDS: J1.17, J1.18, J1.83, J1.84
unnamed: D1.2 (A), Q1.4 (G), R2.1
unnamed: D2.1 (A1), J2.1, J2.2, J2.3, Q1.5 (D), Q1.6 (D), Q1.7 (D), Q1.8 (D), R1.1
VBUS: D1.1 (K), J1.61, J1.63, Q1.1 (S), Q1.2 (S), Q1.3 (S), R1.2; also elsewhere on the board

Notes on the sheet:
ETH
POWER
COMM
POWER INPUT 5-60V

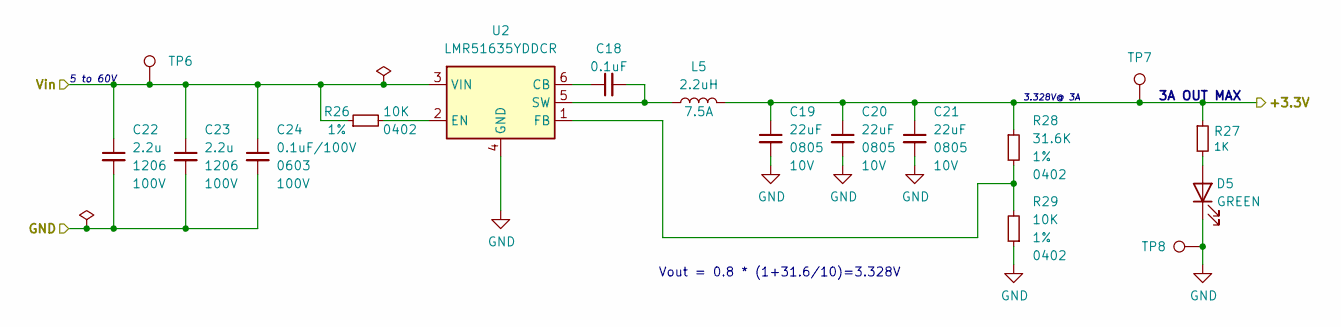
[picture p16: schematic Power.kicad_sch, RouterCoreNanoBase]

Parts:
C18: 0.1uF; C_0402_Small; VOLTAGE 50V; TOLERANCE 10%; MFG1_PART# GCM155R71H104KE02D; LCSC# C85858
C19, C20, C21: 22uF; C_0805_2012Metric; VOLTAGE 10V; TOLERANCE 20%; MFG1_PART# GRM21BZ71A226ME15L; LCSC# C907991
C22, C23: 2.2u; C_1206_Small; VOLTAGE 100V; TOLERANCE 10%; MFG1_PART# CL31B225KCHSNNE; LCSC# C170101
C24: 0.1uF/100V; C_0603_Small; VOLTAGE 100V; TOLERANCE 10%; MFG1_PART# CC0603KRX7R0BB104; LCSC# C113803
D5: GREEN; LED_0402_1005Metric; MFG2_PART# APHHS1005CGCK; LCSC# C264408
L5: 2.2uH; L_Sunlord_MWSA0503S; TOLERANCE ±20%; MFG1_PART# MWSA0503S-2R2MT; LCSC# C408408
R26, R29: 10K; R_0402_1005Metric; TOLERANCE 1%; MFG1_PART# RC0402FR-0710KL; LCSC# C60490
R27: 1K; R_0402_1005Metric; TOLERANCE 1%; MFG1_PART# RC0402FR-071KL; LCSC# C106235
R28: 31.6K; R_0402_1005Metric; TOLERANCE 1%; MFG1_PART# RC0402FR-0731K6L; LCSC# C276265
TP6, TP7, TP8: TP; TestPoint_Pad_D1.0mm; MFG1_PART# DNP
U2: LMR51635YDDCR; SOT-23-6; MFG1_PART# LMR51635YDDCR; JLC C45262770

Connections:
+3V3: C19.1, C20.1, C21.1, L5.2, R27.1, R28.1, TP7.1; also elsewhere on the board
GND: C19.2, C20.2, C21.2, C22.2, C23.2, C24.2, D5.1 (K), R29.1, TP8.1, U2.4 (GND); also elsewhere on the board
unnamed: D5.2 (A), R27.2
unnamed: C18.1, U2.6 (CB)
unnamed: R26.2, U2.2 (EN)
unnamed: R28.2, R29.2, U2.1 (FB)
unnamed: C18.2, L5.1, U2.5 (SW)
VBUS: C22.1, C23.1, C24.1, R26.1, TP6.1, U2.3 (VIN); also elsewhere on the board

Notes on the sheet:
3A OUT MAX
5 to 60V
Vout = 0.8 * (1+31.6/10)=3.328V
3.328V@ 3A

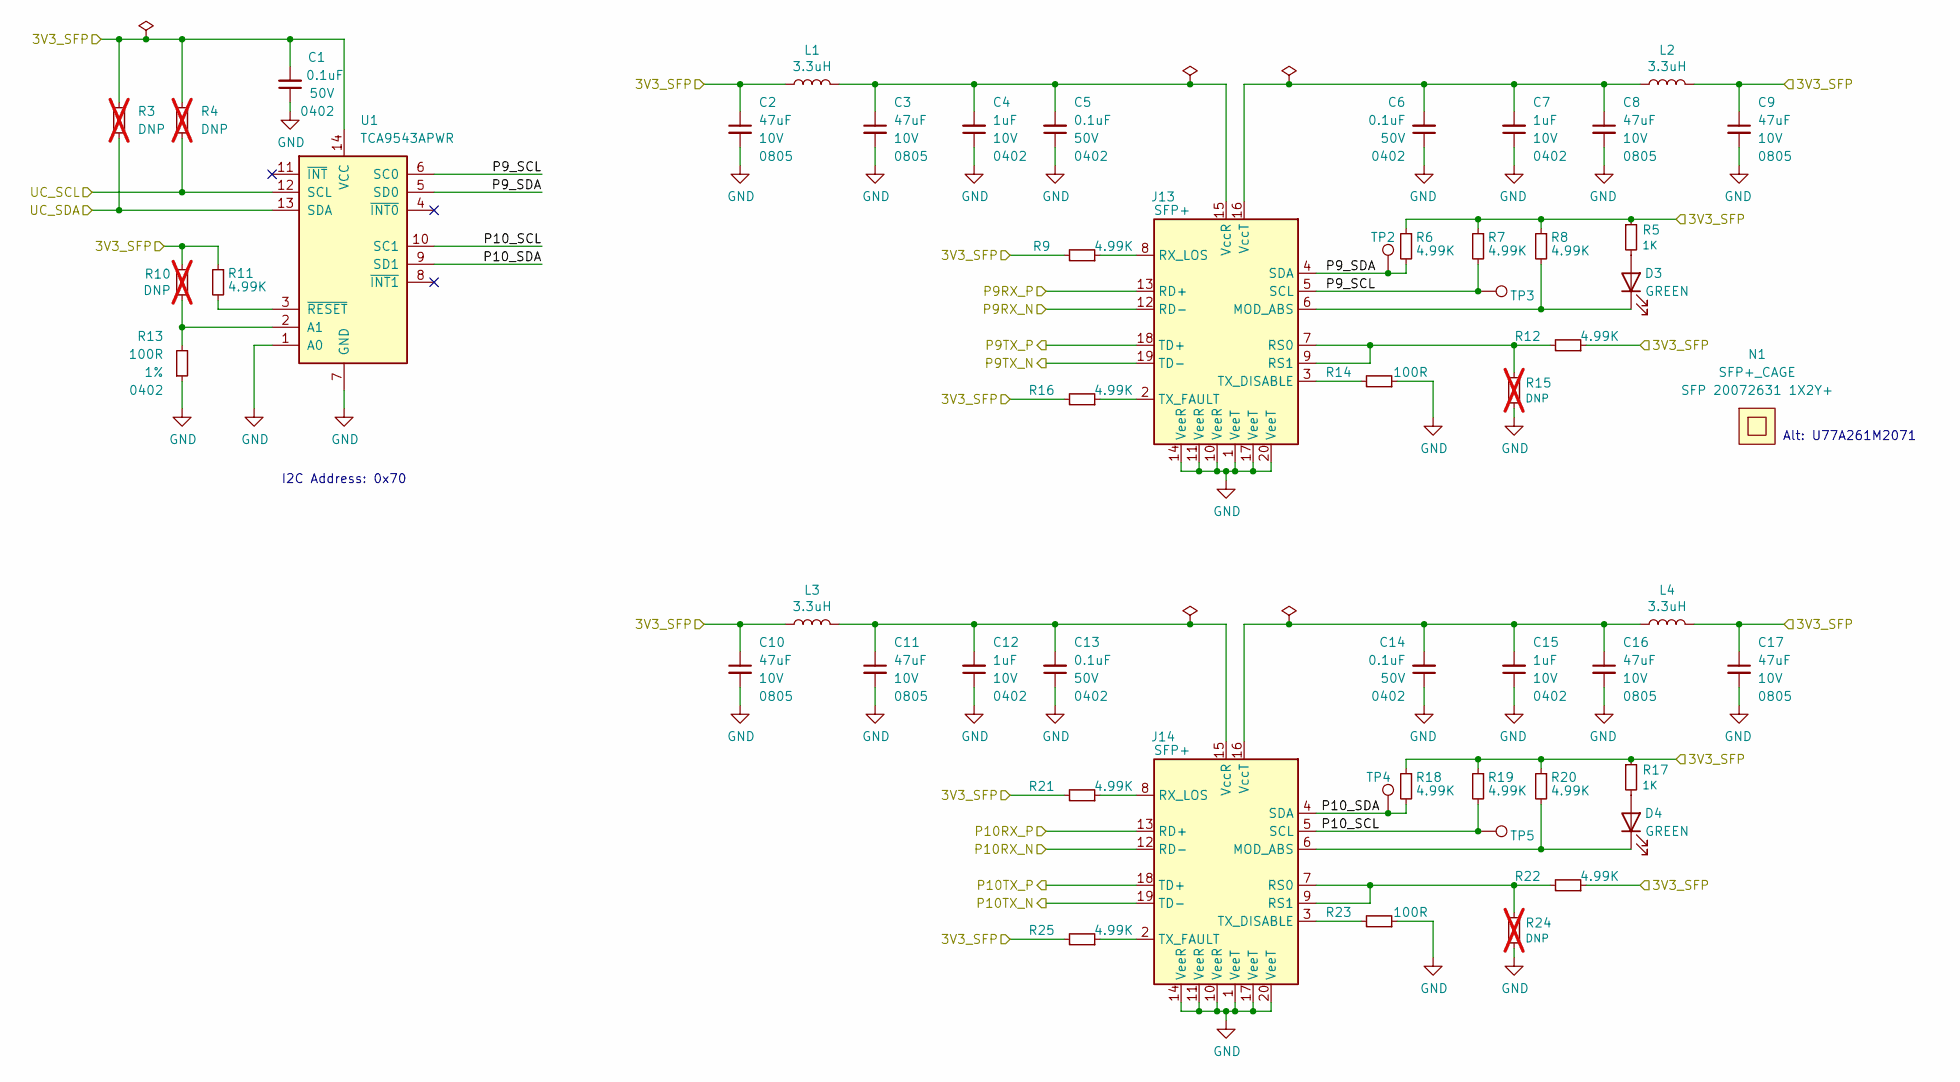
[picture p17: schematic SFP+.kicad_sch, RouterCoreNanoBase]

Parts:
C1, C5, C6, C13, C14: 0.1uF; C_0402_Small; VOLTAGE 50V; TOLERANCE 10%; MFG1_PART# GCM155R71H104KE02D; LCSC# C85858
C2, C3, C8, C9, C10, C11, C16, C17: 47uF; C_0805_2012Metric; VOLTAGE 10V; TOLERANCE 20%; MFG1_PART# C2012X5R1A476MTJ00E; LCSC# C76636
C4, C7, C12, C15: 1uF; C_0402_Small; VOLTAGE 10V; TOLERANCE 10%; MFG1_PART# GRM155C81A105KA12D; LCSC# C162161
D3, D4: GREEN; LED_0402_1005Metric; MFG2_PART# APHHS1005CGCK; LCSC# C264408
J13, J14: SFP+; Connector_SFP; MFG1_PART# 0744410001; LCSC# C277615
L1, L2, L3, L4: 3.3uH; L_1008_2520Metric; MFG1_PART# DFE252012F-3R3M=P2; LCSC# C2041573
N1: SFP+_CAGE; AMPHENOL_U77A261M2071; MFG1_PART# SFP 20072631 1X2Y+; JLC C42931391
R3, R4, R10, R15, R24: DNP; R_0402_1005Metric; MFG1_PART# DNP; not fitted
R5, R17: 1K; R_0402_1005Metric; TOLERANCE 1%; MFG1_PART# RC0402FR-071KL; LCSC# C106235
R6, R7, R8, R9, R11, R12, R16, R18, R19, R20, R21, R22, R25: 4.99K; R_0402_1005Metric; TOLERANCE 1%; MFG1_PART# RC0402FR-074K99L; LCSC# C137965
R13, R14, R23: 100R; R_0402_1005Metric; TOLERANCE 1%; MFG1_PART# RC0402FR-07100RL; LCSC# C106232
TP2, TP3, TP4, TP5: TP; TestPoint_Pad_D1.0mm; MFG1_PART# DNP
U1: TCA9543APWR; TSSOP-14_4.4x5mm_P0.65mm; MFG1_PART# TCA9543APWR; JLC C2653307

Connections:
+3V3: C1.2, C2.1, C9.1, C10.1, C17.1, L1.1, L2.1, L3.1, L4.1, R3.1, R4.1, R5.1, R6.1, R7.1, R8.1, R9.2, R10.2, R11.1, R12.1, R16.2, R17.1, R18.1, R19.1, R20.1, R21.2, R22.1, R25.2, U1.14 (VCC); also elsewhere on the board
/C_EX_SCL: R4.2, U1.12 (SCL); also elsewhere on the board
/C_EX_SDA: R3.2, U1.13 (SDA); also elsewhere on the board
/R9_RX_N: J13.12 (RD-); also elsewhere on the board
/R9_RX_P: J13.13 (RD+); also elsewhere on the board
/R9_TX_N: J13.19 (TD-); also elsewhere on the board
/R9_TX_P: J13.18 (TD+); also elsewhere on the board
/R10_RX_N: J14.12 (RD-); also elsewhere on the board
/R10_RX_P: J14.13 (RD+); also elsewhere on the board
/R10_TX_N: J14.19 (TD-); also elsewhere on the board
/R10_TX_P: J14.18 (TD+); also elsewhere on the board
/SFP+/P9_SCL: J13.5 (SCL), R7.2, TP3.1, U1.6 (SC0)
/SFP+/P9_SDA: J13.4 (SDA), R6.2, TP2.1, U1.5 (SD0)
/SFP+/P10_SCL: J14.5 (SCL), R19.2, TP5.1, U1.10 (SC1)
/SFP+/P10_SDA: J14.4 (SDA), R18.2, TP4.1, U1.9 (SD1)
GND: C1.1, C2.2, C3.2, C4.1, C5.1, C6.1, C7.1, C8.2, C9.2, C10.2, C11.2, C12.1, C13.1, C14.1, C15.1, C16.2, C17.2, J13.1 (VeeT), J13.10 (VeeR), J13.11 (VeeR), J13.14 (VeeR), J13.17 (VeeT), J13.20 (VeeT), J14.1 (VeeT), J14.10 (VeeR), J14.11 (VeeR), J14.14 (VeeR), J14.17 (VeeT), J14.20 (VeeT), R13.1, R14.1, R15.1, R23.1, R24.1, U1.1 (A0), U1.7 (GND); also elsewhere on the board
unnamed: D3.2 (A), R5.2
unnamed: D3.1 (K), J13.6 (MOD_ABS), R8.2
unnamed: D4.2 (A), R17.2
unnamed: D4.1 (K), J14.6 (MOD_ABS), R20.2
unnamed: J13.7 (RS0), J13.9 (RS1), R12.2, R15.2
unnamed: J13.8 (RX_LOS), R9.1
unnamed: J13.3 (TX_DISABLE), R14.2
unnamed: J13.2 (TX_FAULT), R16.1
unnamed: C3.1, C4.2, C5.2, J13.15 (VccR), L1.2
unnamed: C6.2, C7.2, C8.1, J13.16 (VccT), L2.2
unnamed: J14.7 (RS0), J14.9 (RS1), R22.2, R24.2
unnamed: J14.8 (RX_LOS), R21.1
unnamed: J14.3 (TX_DISABLE), R23.2
unnamed: J14.2 (TX_FAULT), R25.1
unnamed: C11.1, C12.2, C13.2, J14.15 (VccR), L3.2
unnamed: C14.2, C15.2, C16.1, J14.16 (VccT), L4.2
unnamed: R10.1, R13.2, U1.2 (A1)
unnamed: R11.2, U1.3 (~RESET)

Notes on the sheet:
Alt: U77A261M2071
I2C Address: 0x70

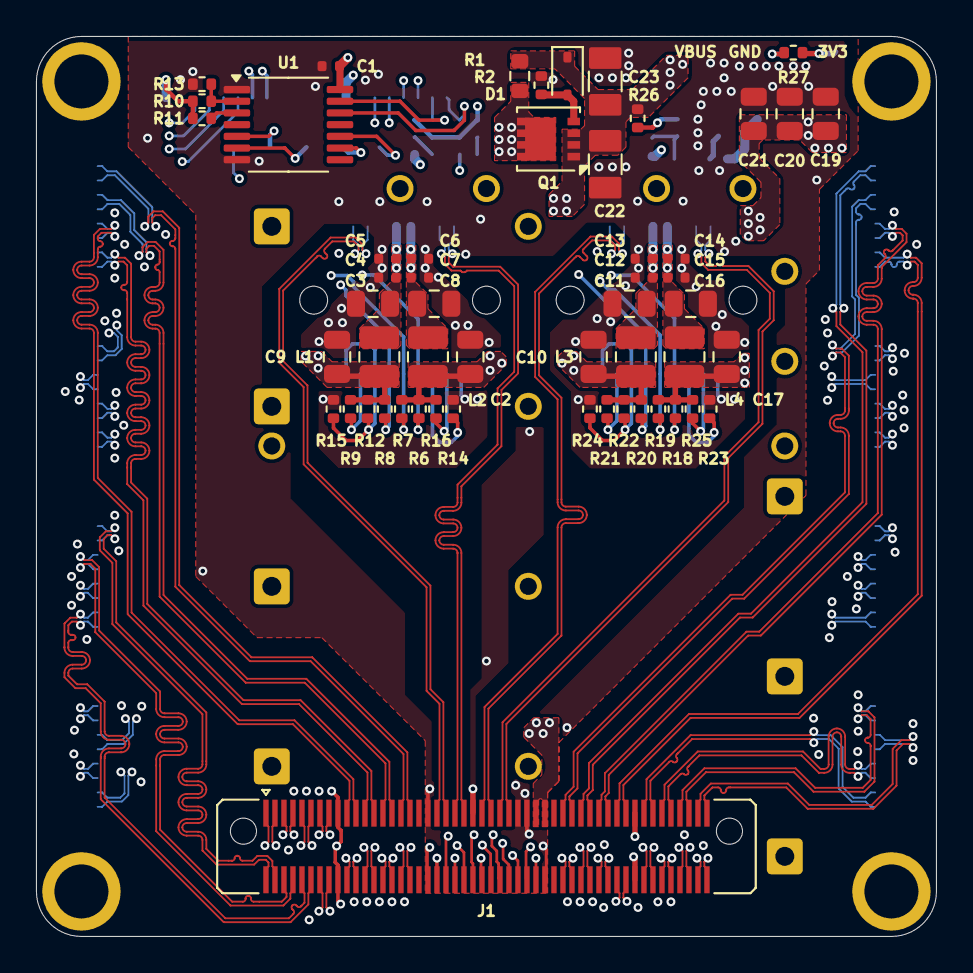
[picture p18: board RouterCoreNanoBaseRevA.kicad_pcb from above]

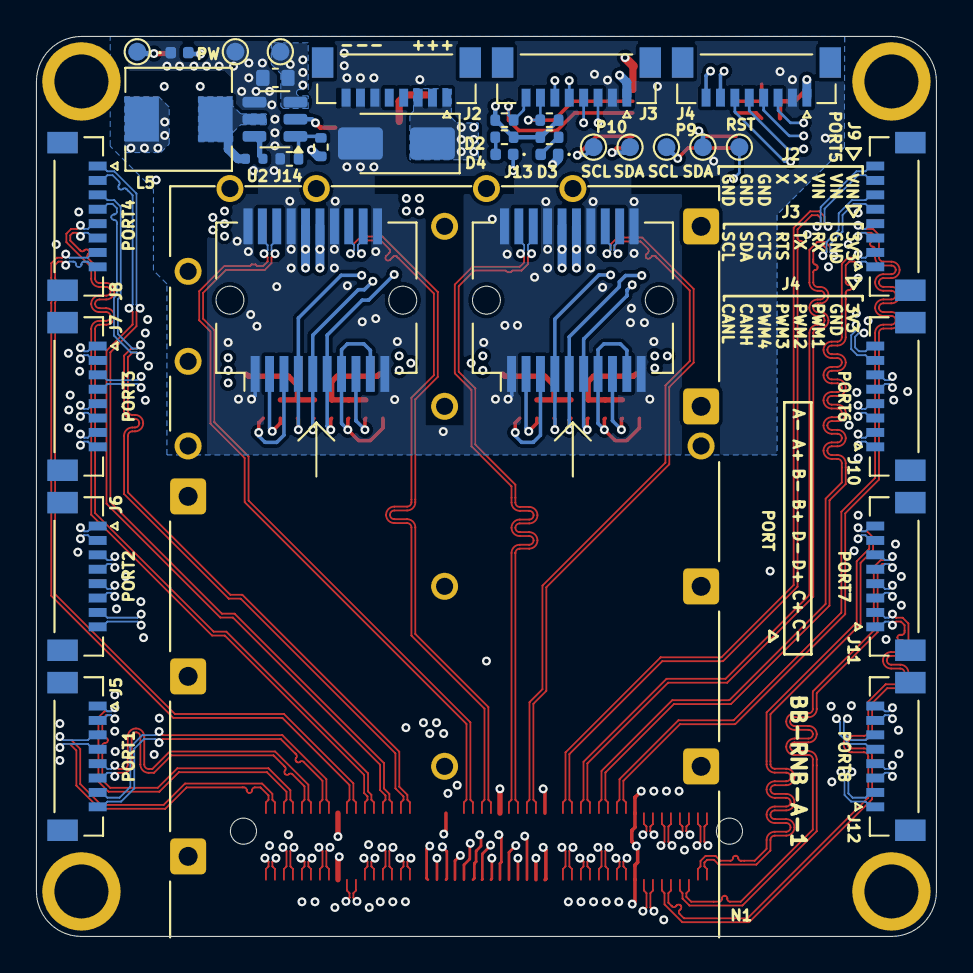
[picture p19: board RouterCoreNanoBaseRevA.kicad_pcb from below]

Board: 6 copper layers, 50.0 x 50.0 mm, 93 parts (36 on the bottom side), 118 nets.
